EyitopeIO/Final-year-project/README.md

# Final-year-project
My final year project for a B.Eng in electrical and electronics engineering is to digitally track medical samples in transit, making information about its state available for medical officers to see. A cooler made of styrofoam is equipped with sensors and necessary electronics to connect it to the internet. 

Visit FirmwareREADME.txt and the user guide (author's note) before attempting to use the system.
