EyitopeIO/Final-year-project/Circuit diagram 3 - original.jpg

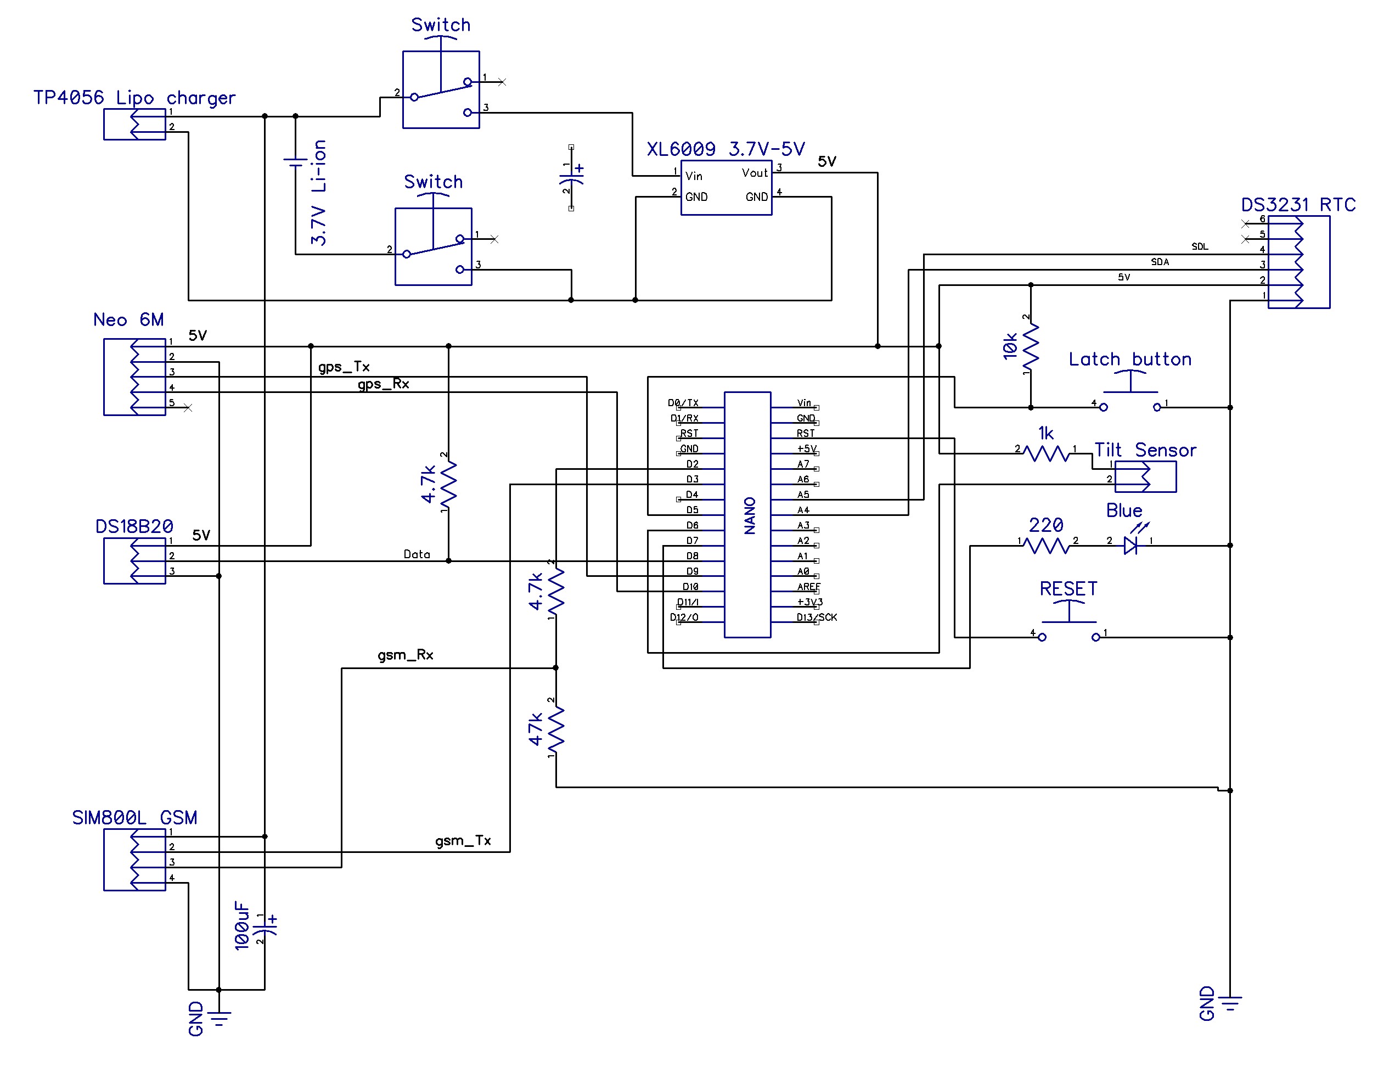
Circuit diagram 3 - original.jpg
