EyitopeIO/Final-year-project/Circuit diagram 4 - Diptrace.png

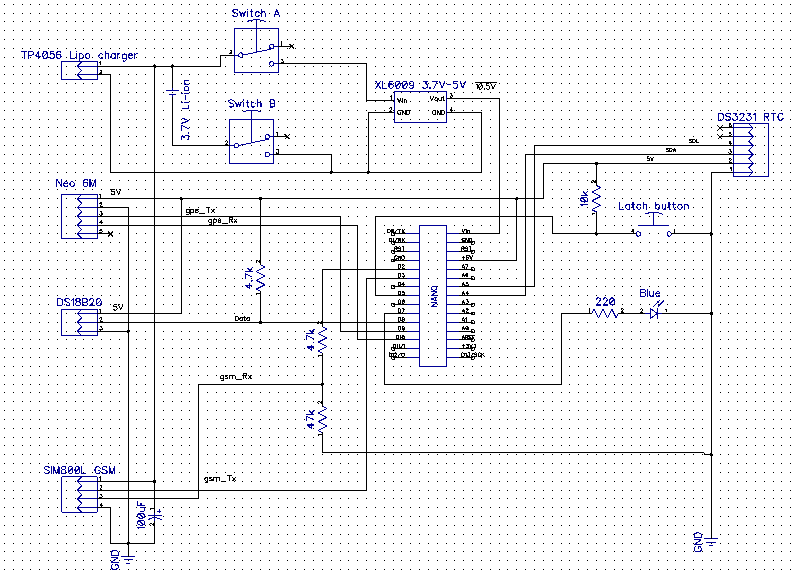
Circuit diagram 4 - Diptrace.png
