EyitopeIO/Final-year-project/(list of files, drawings)

Other design files:
Circuit diagram 2 - Diptrace.dch
Circuit diagram 3 - Diptrace.dch
Circuit diagram 4 - Diptrace.dch
Circuit diagram - Diptrace.dch
