EyitopeIO/Final-year-project/(commit log)

2020-02-12 Add files via upload
    Circuit files.
    [Circuit diagram - Diptrace.dch, Circuit diagram 2 - Diptrace.dch, Circuit diagram 3 - Diptrace.dch]
2020-02-13 Add files via upload
    "OneWire" for the temperature sensor; "RTClib" for the real-time clock; "TinyGPSPlus-master" for the GPS module
